msaribekyan/secure_lora/README.md

# secure_lora
Secure LoRa Wireless Message Transmission System
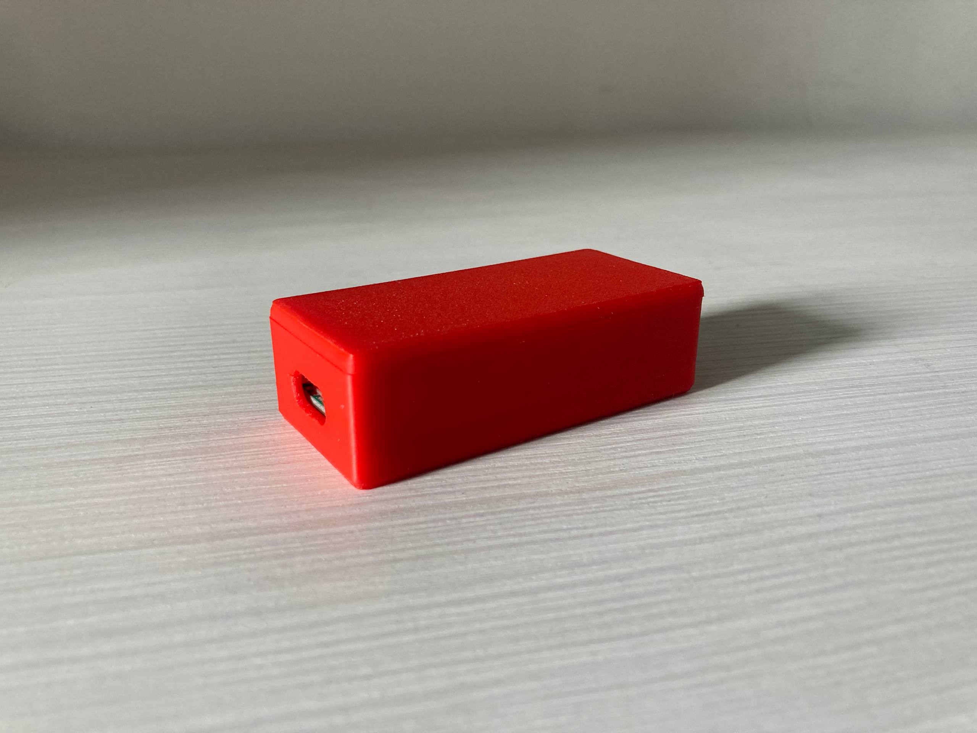
[picture p1: images/isometric.jpg]


## Schematic
A node is based on an STM32F042 development board and Ra-02 SX1278 module.
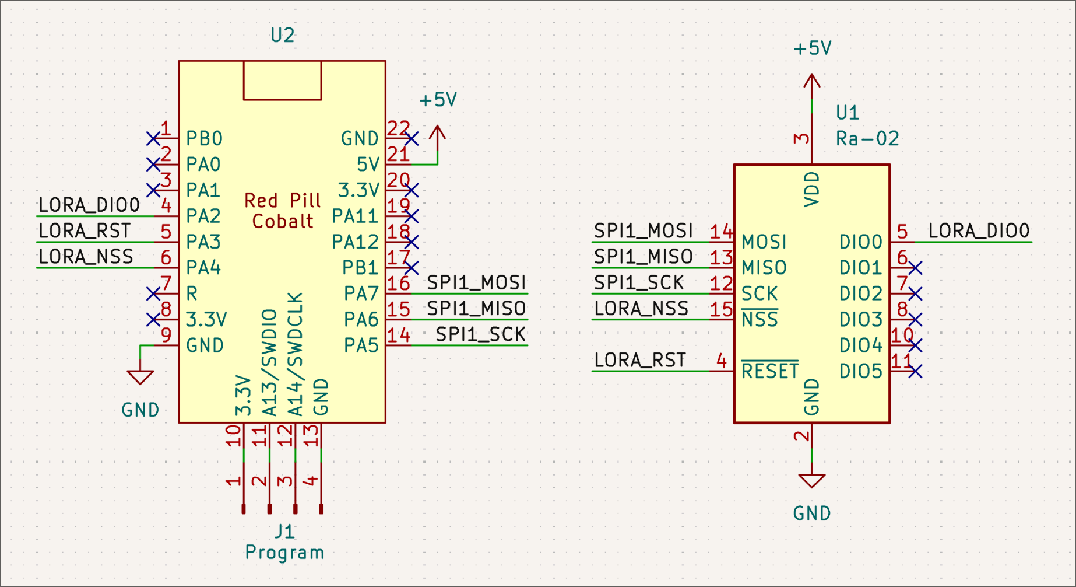
[picture p2: images/schematic.png]
