msaribekyan/secure_lora/src/cli/README.md

# CLI tool to communicate with LoRa nodes over USB serial

# pip install -r requirements.txt or just 
# pyserial

# run list_ports with the board plugged in # to get the port number

# after getting the port number, use the optional cli arg --port to start the serial
