msaribekyan/secure_lora/images/top_view.jpg

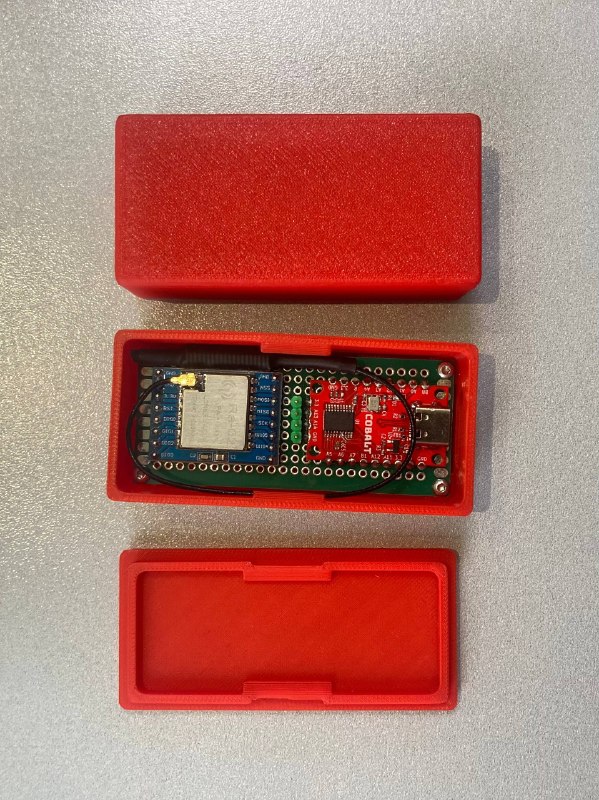
images/top_view.jpg
