msaribekyan/secure_lora/src/models/enclosure_lid.step

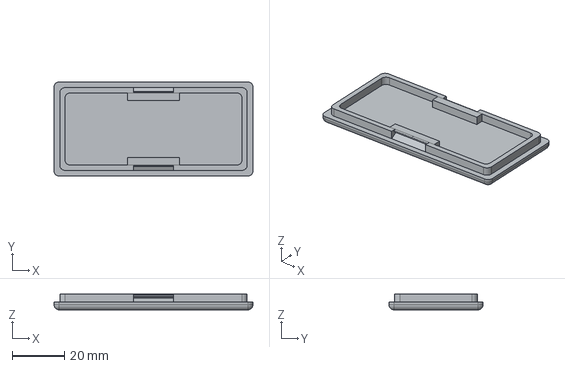
[picture p6: CAD file, 2026-10-02]
src/models/enclosure_lid.step
76.0 x 36.0 x 6.00 mm
