msaribekyan/secure_lora/src/models/enclosure_base.step

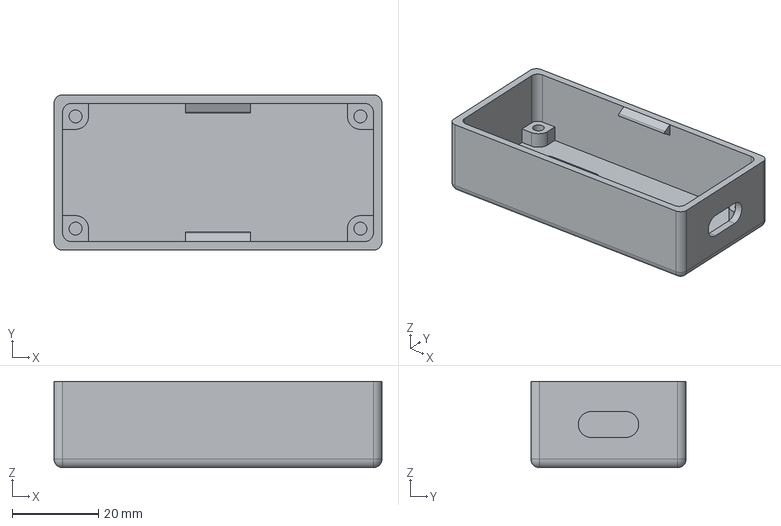
[picture p7: CAD file, 2026-10-02]
src/models/enclosure_base.step
76.0 x 36.0 x 20.0 mm
