msaribekyan/secure_lora/(list of files, cad)

Other CAD files:
src/models/enclosure_base.FCStd
src/models/enclosure_lid.FCStd
