msaribekyan/secure_lora/src/firmware/secure_lora.ioc

Mcu.UserName=STM32F042F6Px
PA0.GPIO_Label=LED
PA0.Signal=GPIO_Output
PA11.Signal=USB_DM
PA12.Signal=USB_DP
PA13.Signal=SYS_SWDIO
PA14.Signal=SYS_SWCLK
PA2.GPIO_Label=LORA_DIO0
PA2.Signal=GPIO_Input
PA3.GPIO_Label=LORA_RST
PA3.Signal=GPIO_Output
PA4.GPIO_Label=LORA_NSS
PA4.Signal=GPIO_Output
PA5.Signal=SPI1_SCK
PA6.Signal=SPI1_MISO
PA7.Signal=SPI1_MOSI
PF0-OSC_IN.Signal=RCC_OSC_IN
PF1-OSC_OUT.Signal=RCC_OSC_OUT
