msaribekyan/secure_lora/src/firmware/Core/Inc/main.h

#define LED_Pin GPIO_PIN_0
#define LED_GPIO_Port GPIOA
#define LORA_DIO0_Pin GPIO_PIN_2
#define LORA_DIO0_GPIO_Port GPIOA
#define LORA_RST_Pin GPIO_PIN_3
#define LORA_RST_GPIO_Port GPIOA
#define LORA_NSS_Pin GPIO_PIN_4
#define LORA_NSS_GPIO_Port GPIOA
