msaribekyan/secure_lora/src/firmware/Drivers/lora_driver/lora_reg.h

#ifndef LORA_REG_H
#define LORA_REG_H

#define REG_FIFO                    0x00

#define REG_OP_MODE                 0x01

#define REG_FRF_MSB                 0x06
#define REG_FRF_MID                 0x07
#define REG_FRF_LSB                 0x08

#define REG_PA_CONFIG               0x09
#define REG_PA_RAMP                 0x0A
#define REG_OCP                     0x0B
#define REG_LNA                     0x0C

#define REG_FIFO_ADDR_PTR           0x0D
#define REG_FIFO_TX_BASE_ADDR       0x0E
#define REG_FIFO_RX_BASE_ADDR       0x0F

#define REG_FIFO_RX_CURRENT_ADDR	0x10
#define REG_IRQ_FLAGS_MASK          0x11
#define REG_IRQ_FLAGS               0x12
#define REG_RX_NB_BYTES				0x13
#define REG_MODEM_CONFIG1           0x1D
#define REG_MODEM_CONFIG2           0x1E
#define REG_PREAMBLE_MSB            0x20
#define REG_PREAMBLE_LSB            0x21
#define REG_PAYLOAD_LENGTH          0x22
#define REG_MODEM_CONFIG3           0x26

#define REG_SYNC_WORD               0x39

#define REG_VERSION                0x42

#endif // LORA_REG_H
