msaribekyan/secure_lora/src/keygen/test_aes.c

// test aes implementation using test vectors defined in
// https://nvlpubs.nist.gov/nistpubs/FIPS/NIST.FIPS.197.pdf Apprendix C1

// PLAINTEXT: 00112233445566778899aabbccddeeff
// KEY: 000102030405060708090a0b0c0d0e0f
// CIPHERTEXT: 69c4e0d86a7b0430d8cdb78070b4c55a
#include <stdio.h>
#include <stdint.h>

void aes128_encrypt_block(const uint8_t key[16], const uint8_t input[16], uint8_t output[16]);

int main(void)
{
    const uint8_t plaintext[16] = {
        0x00, 0x11, 0x22, 0x33,
        0x44, 0x55, 0x66, 0x77,
        0x88, 0x99, 0xaa, 0xbb,
        0xcc, 0xdd, 0xee, 0xff
    };

    const uint8_t key[16] = {
        0x00, 0x01, 0x02, 0x03,
        0x04, 0x05, 0x06, 0x07,
        0x08, 0x09, 0x0a, 0x0b,
        0x0c, 0x0d, 0x0e, 0x0f
    };

    const uint8_t expected[16] = {
        0x69, 0xc4, 0xe0, 0xd8,
        0x6a, 0x7b, 0x04, 0x30,
        0xd8, 0xcd, 0xb7, 0x80,
        0x70, 0xb4, 0xc5, 0x5a
    };

    uint8_t output[16];
    
    aes128_encrypt_block(key, plaintext, output);

    for (int i = 0; i < 16; i++) {
        if (output[i] != expected[i]) {
            printf("AES test failed");
            return 1;
        }
    }
    printf("AES test passed\n");

    return 0;
}
