msaribekyan/secure_lora/(commit log)

2026-10-02 Add CLI serial prototype with threaded reader and stub port
2026-10-07 initial working prototype
